SteveLRojas/Dragon_Board/README.md

# Dragon_Board
Custom FPGA board designed for TRS-80 and NES projects.
