SteveLRojas/Dragon_Board/DragonBoard_rev2.0/BOM.ods

Part | #Needed | #Owned | Satisfied? | Location
EP4CE15E22C8N | 1 | 3 | TRUE | Project Box
W9816G6JH | 1 | 10 | TRUE | Project Box
CP2102 | 1 | 1 | TRUE | Project_box
TPD12S016PWR | 1 | 4 | TRUE | Project Box
BY25Q16BS | 2 | 13 | TRUE | Project Box
LM1086 | 1 | 4 | TRUE | Regulator Box
LD1117D-3.3 | 1 | 6 | TRUE | Regulator Box
KIA1117-2.5 | 1 | 6 | TRUE | Regulator Box
AZ1117H-1.2TRG1 | 1 | 6 | TRUE | Regulator Box
PMBT3904 | 6 | 40 | TRUE | Project Box
MBRA340T3 (SS24) | 2 | 12 | TRUE | Project Box
LED 0805 Orange | 1 | 1000 | TRUE | Project Box
OT705050MJBA4SL (50 MHz) | 1 | 3 | TRUE | Crystal Box
CBG201209U601T (ferrite) | 4 | 30 | TRUE | Project Box
Barrel jack | 1 | 3 | TRUE | Connector Box
PMOD socket | 1 | 25 | TRUE | Project Box
Mini DIN-6 socket | 3 | 7 | TRUE | Connector Box
HDMI socket | 1 | 9 | TRUE | Connector Box
USB-B socket | 1 | 2 | TRUE | Connector Box
Pin header 2x5 | 2 | 3 | TRUE | Connector Box
3.5mm audio jack | 1 | 25 | TRUE | Connector Box
LL3301NF065QG | 5 | 100 | TRUE | Project Box
Resistor 10K 0805 | 17 | 500 | TRUE | Box 8
Resistor 5K6 0805 | 11 | 500 | TRUE | Box 8
Resistor 1K 0805 | 7 | 90 | TRUE | Box 8
Resistor 2K2 0805 | 1 | 300 | TRUE | Box 8
Resistor 50 0805 | 8 | 500 | TRUE | Box 8
Resistor 33 0805 | 2 | 200 | TRUE | Box 8
Capacitor 0.1u 0805 | 42 | 100 | TRUE | Box 7
NXA_35V100_6.3X11 | 1 | 4 | TRUE | Capacitor Box
Capacitor 100u electrolytic | 5 | 8 | TRUE | Capacitor Box
Capacitor 10u 1206 | 2 | 200 | TRUE | Project Box
