SteveLRojas/Dragon_Board/(commit log)

2021-05-07 Added Eagle files
    [TRS-80.brd, TRS-80.sch]
2021-08-12 new revisions
    [TRS-80.GBL, TRS-80.GBO, TRS-80.GBP, TRS-80.GBS, TRS-80.GKO, TRS-80.GTL, TRS-80.GTO, TRS-80.GTP]
2024-01-03 Added revision 2.0
    [DragonBoard.GBL, DragonBoard.GBO, DragonBoard.GBP, DragonBoard.GBS, DragonBoard.GKO, DragonBoard.GTL, DragonBoard.GTO, DragonBoard.GTP]
2024-02-11 created BOM for rev 2.0
    [BOM.ods]
2025-04-16 fixed HDMI signal names in V2.0, fixed missing I2C resistors in V1.0
    [BOM.ods, DragonBoard.brd, DragonBoard.sch, TRS-80.brd, TRS-80.sch]
